namanPuri/Physics-with-arduino/curve tracer output/26_06_2022/4007-diode-curve-v1.png

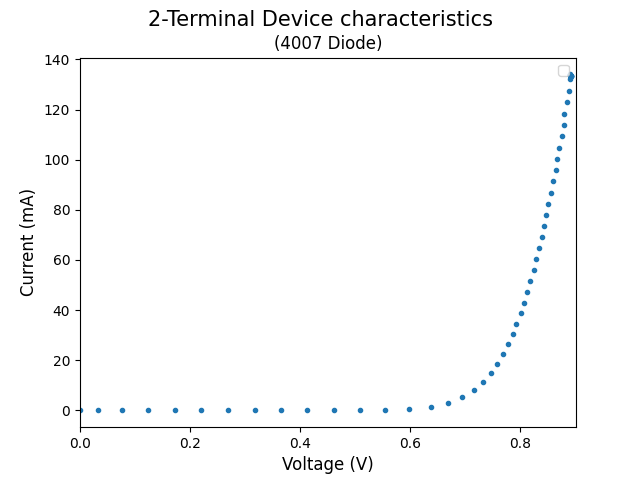
curve tracer output/26_06_2022/4007-diode-curve-v1.png
