namanPuri/Physics-with-arduino/curve tracer output/5819-v1.PNG

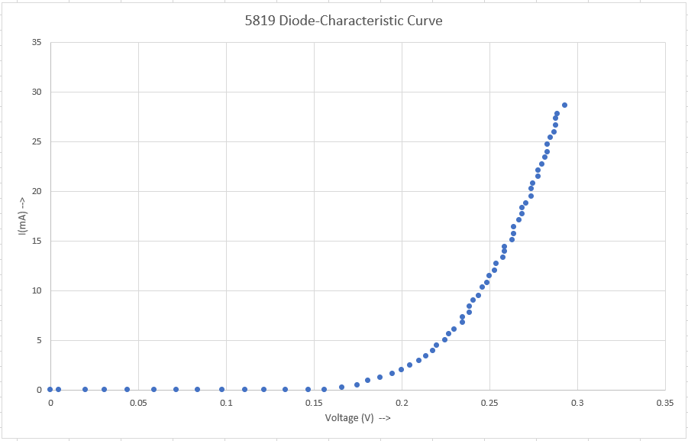
curve tracer output/5819-v1.PNG
