namanPuri/Physics-with-arduino/curve tracer output/5819-v2.PNG

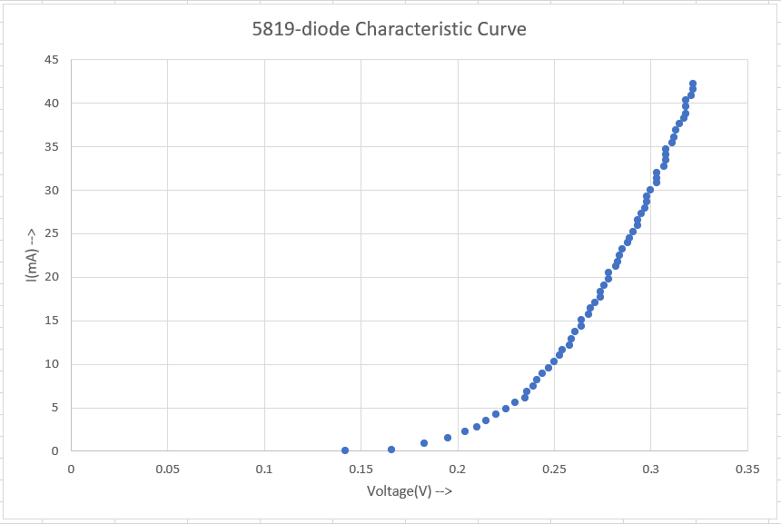
curve tracer output/5819-v2.PNG
