namanPuri/Physics-with-arduino/curve tracer output/blue-led-v1.PNG

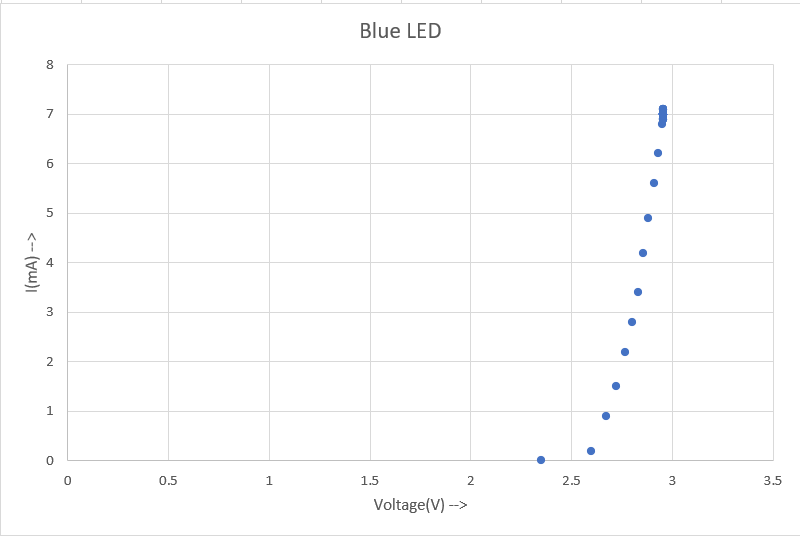
curve tracer output/blue-led-v1.PNG
