namanPuri/Physics-with-arduino/curve tracer output/blue-led-v2-OP07.PNG

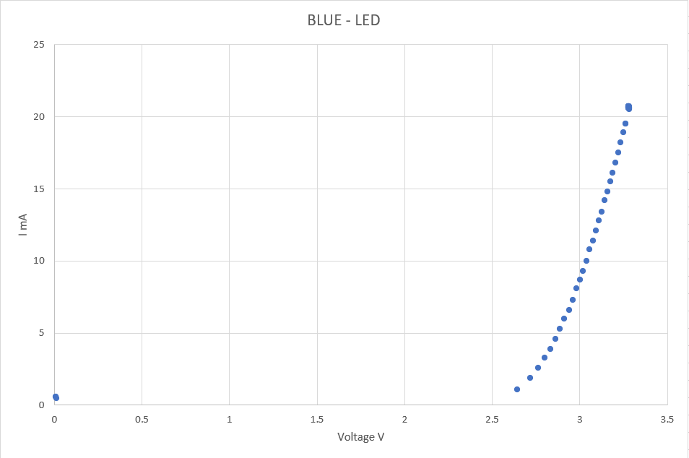
curve tracer output/blue-led-v2-OP07.PNG
