namanPuri/Physics-with-arduino/newtons law of cooling/92-42.PNG

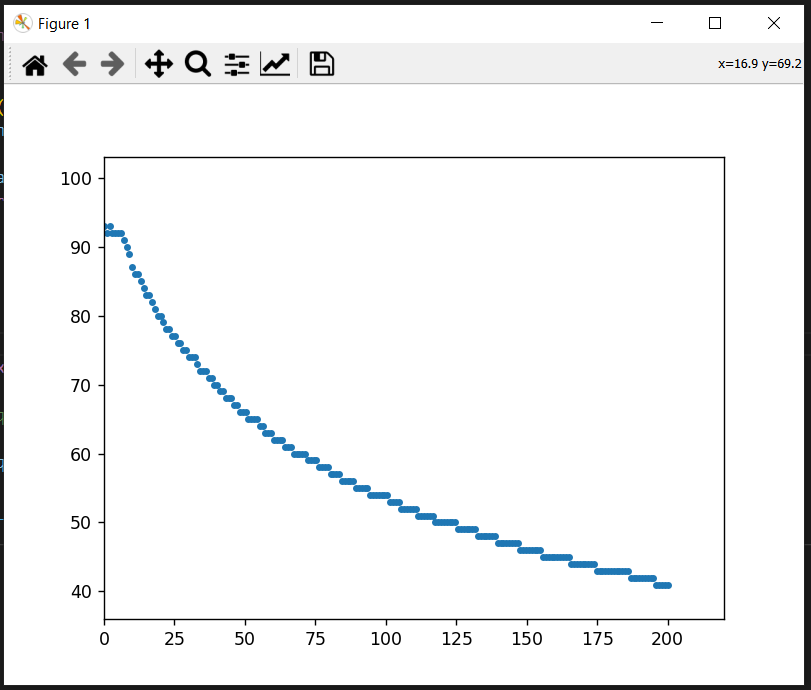
newtons law of cooling/92-42.PNG
