namanPuri/Physics-with-arduino/output/rc-charging-discharging.png

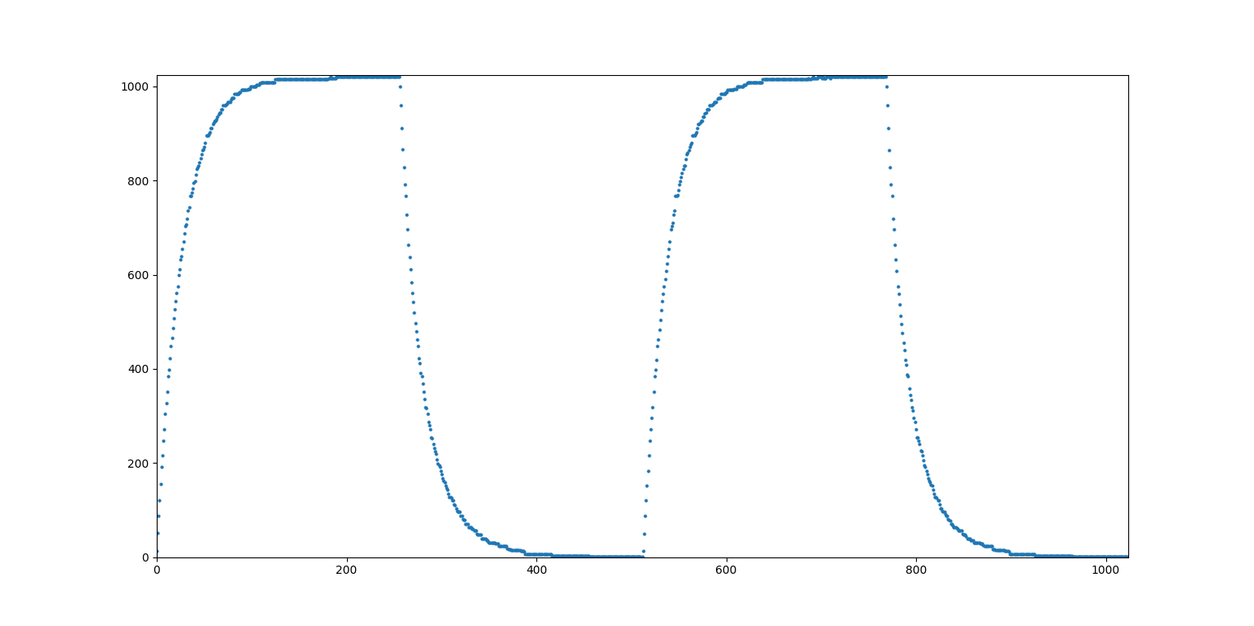
output/rc-charging-discharging.png
