namanPuri/Physics-with-arduino/output/rlc-critically damped.png

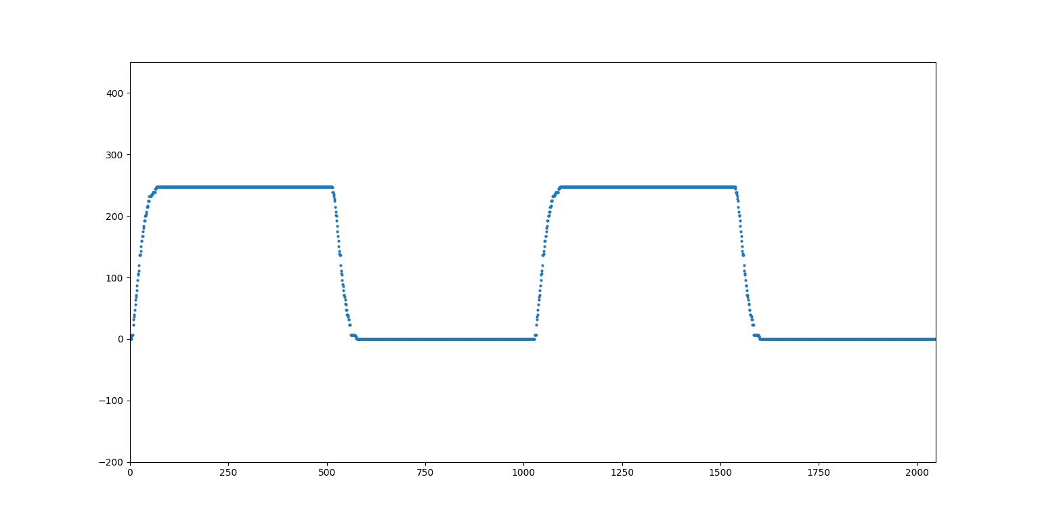
output/rlc-critically damped.png
