namanPuri/Physics-with-arduino/output/rlc-overdamped.png

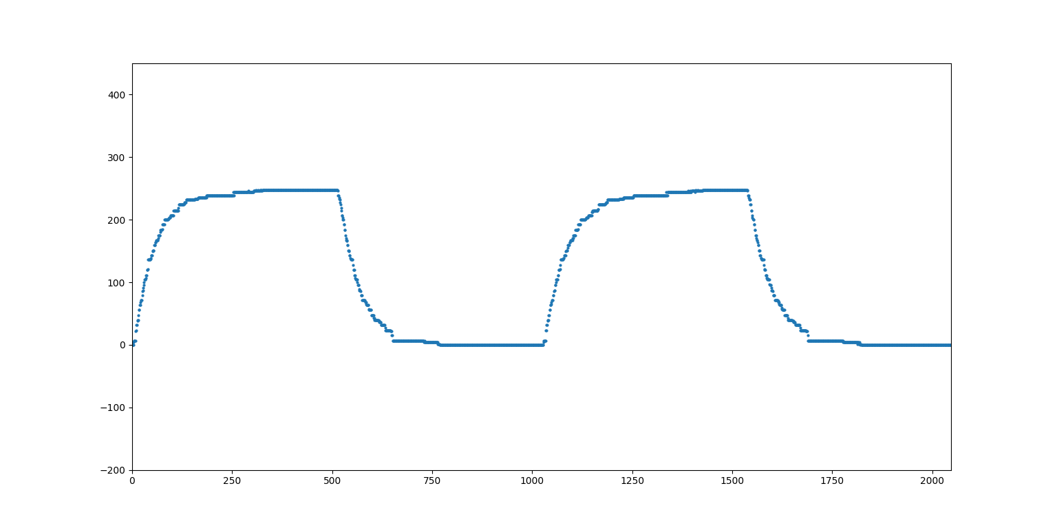
output/rlc-overdamped.png
