namanPuri/Physics-with-arduino/output/rlc-ringing.png

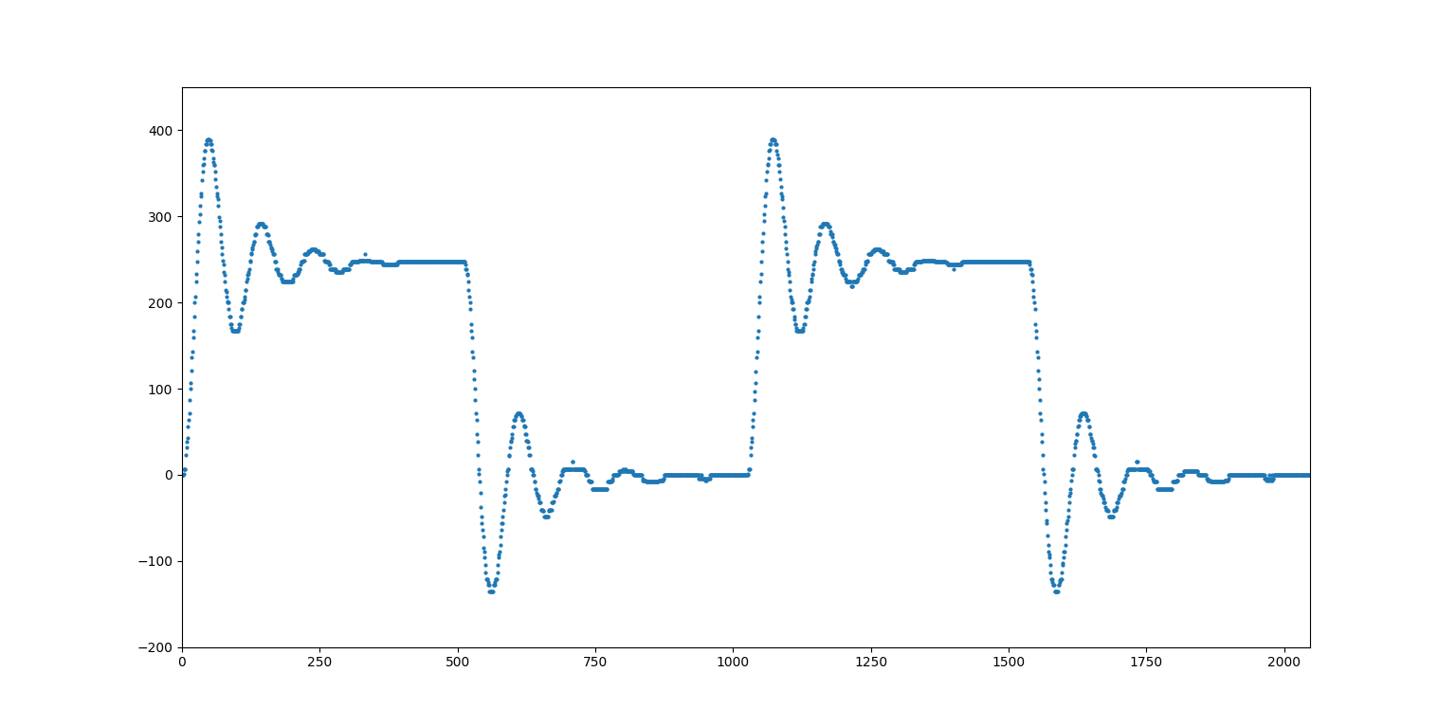
output/rlc-ringing.png
