namanPuri/Physics-with-arduino/ardunio-physics-board-v3.dxf

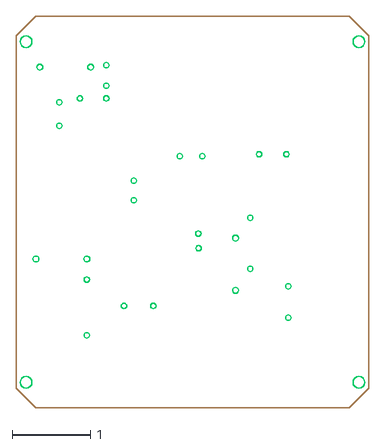
[picture p13: CAD file, 2022-06-27]
ardunio-physics-board-v3.dxf
4.50 x 5.00
