namanPuri/Physics-with-arduino/radiused-0.15.dxf

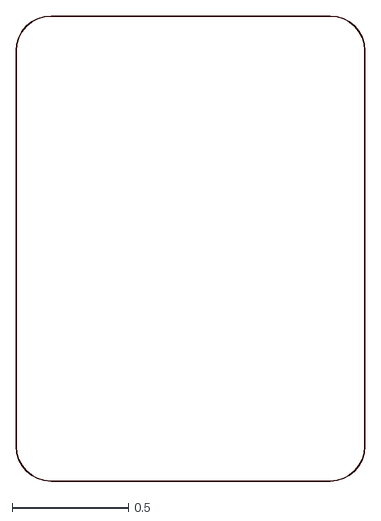
[picture p14: CAD file, 2022-06-27]
radiused-0.15.dxf
1.50 x 2.00
