namanPuri/Physics-with-arduino/Schematic_arduino_physics_V1.pdf

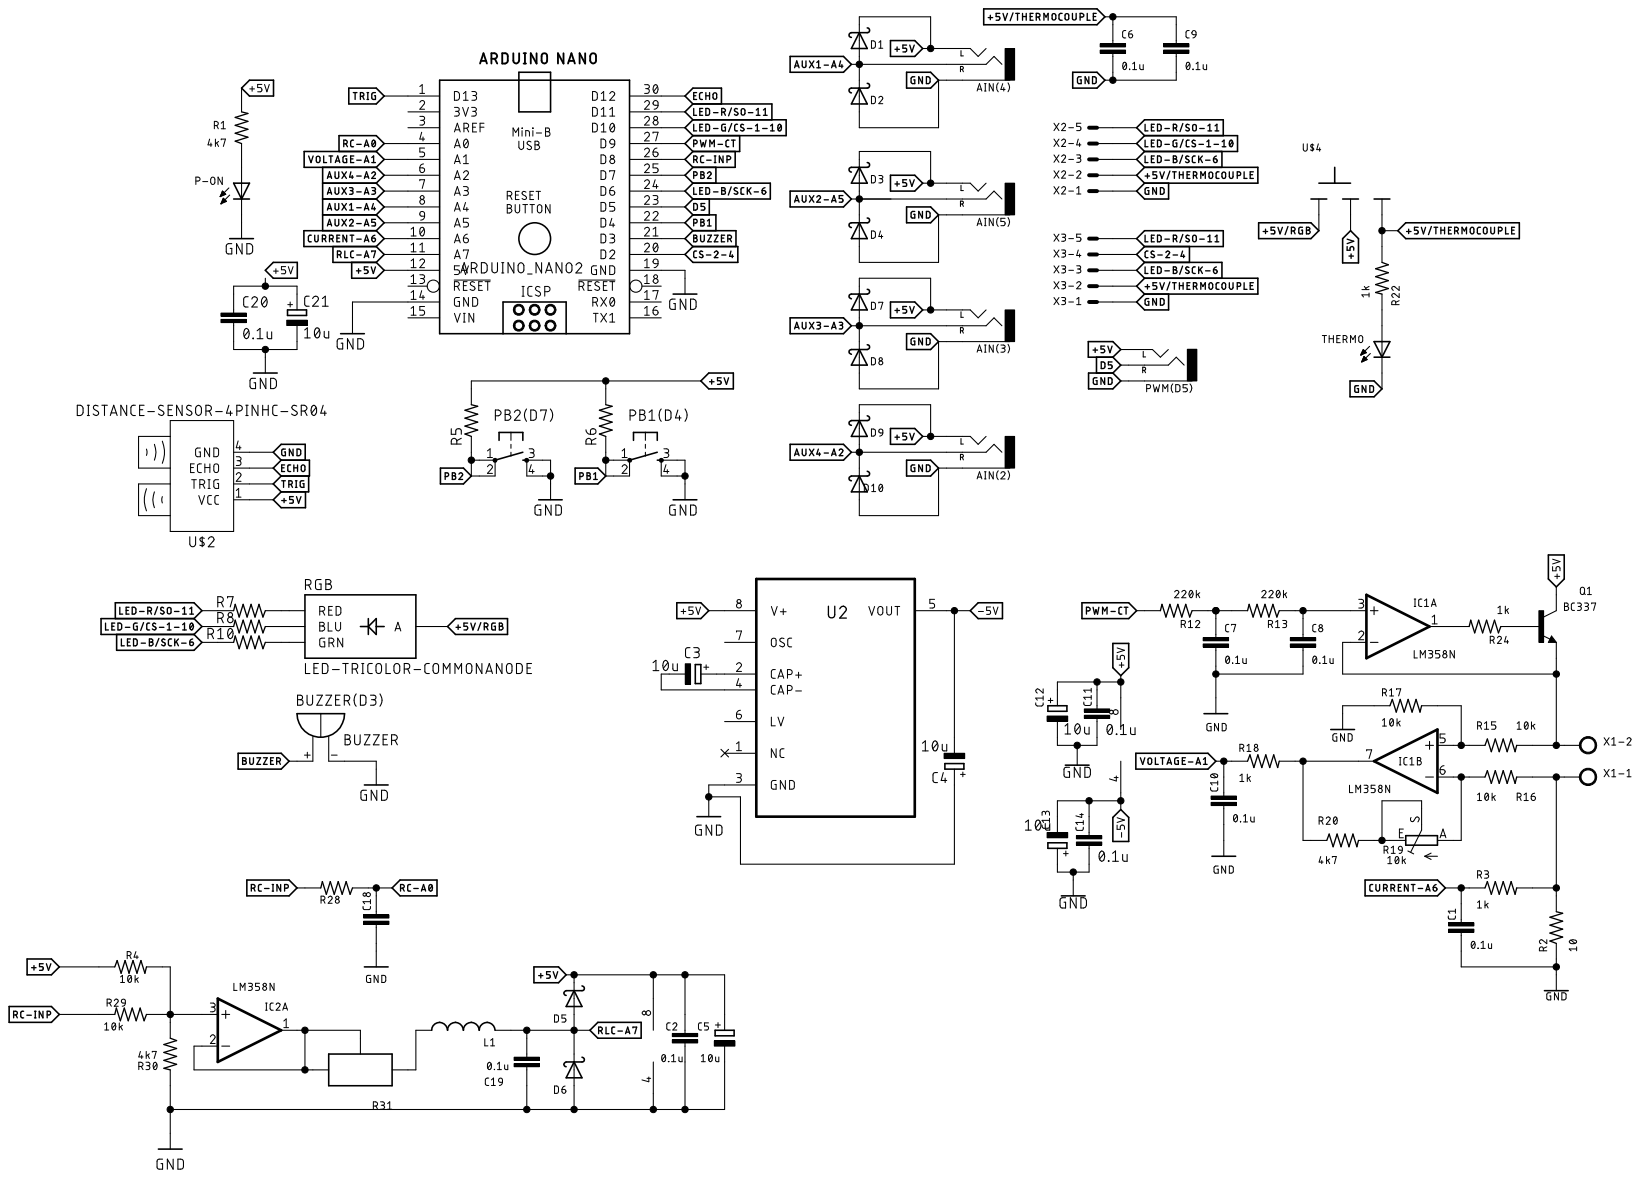
[picture p15: page 1]
