namanPuri/Physics-with-arduino/supplementary boards/mic/mic_v4.brd

## EAGLE design supplementary boards/mic/mic_v4.brd (2022-06-27)

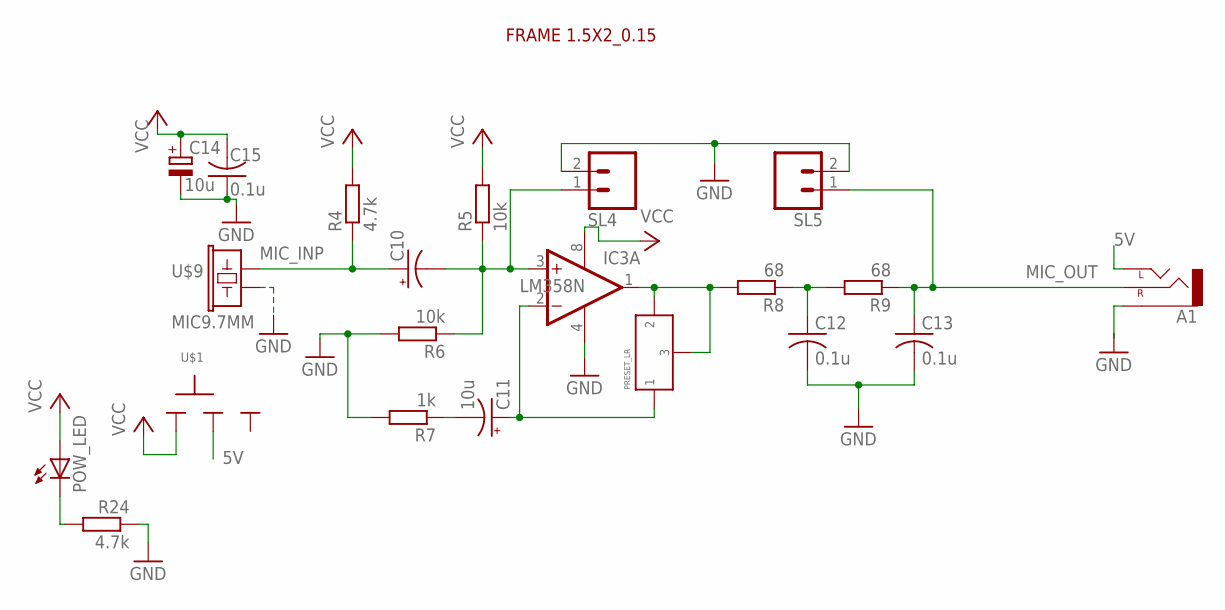
[picture p16: schematic mic_v4.sch]

Parts:
A1: AUX-CONNECTOR_CEDT_JANUARY_2015_V5_AUDIO-JACKPTH; AUX-CONNECTOR_CEDT_JANUARY_2015_V5_AUDIO-JACK
C10: CPOL-USE2.5-5; E2,5-5
C11, C14: 10u; E2,5-5
C12, C13, C15: 0.1u; C025-024X044
IC3: LM358N; DIL08
POW_LED: LED3MM
R4, R24: 4.7k; 0204/7
R5, R6: 10k; 0204/7
R7: 1k; 0204/7
R8, R9: 68; 0204/7
SL4, SL5: M02; 02P
U$1: SLIDESWITCH-BIG; BIGSWITCH
U$2: FRAME_1.5X2_RAD_0.15
U$6: PRESET_LR
U$9: MIC9.7MM; MIC-9.7MM

Connections:
5V: A1.TIP (LEFT), U$1.2
GND: A1.SLEEVE, C12.2, C13.2, C14.-, C15.1, IC3.4 (V-), R6.2, R7.2, R24.1, SL4.2, SL5.2, U$9.2
MIC_INP: C10.+, R4.1, U$9.1
MIC_OUT: A1.RING (RIGHT), C13.1, R9.1, SL5.1
unnamed: IC3.1 (OUT), R8.2, U$6.P$2 (2), U$6.P$3 (3)
unnamed: C12.1, R8.1, R9.2
unnamed: C11.-, R7.1
unnamed: POW_LED.K (C), R24.2
unnamed: C10.-, IC3.3 (+IN), R5.1, R6.1, SL4.1
unnamed: C11.+, IC3.2 (-IN), U$6.P$1 (1)
VCC: C14.+, C15.2, IC3.8 (V+), POW_LED.A, R4.2, R5.2, U$1.1

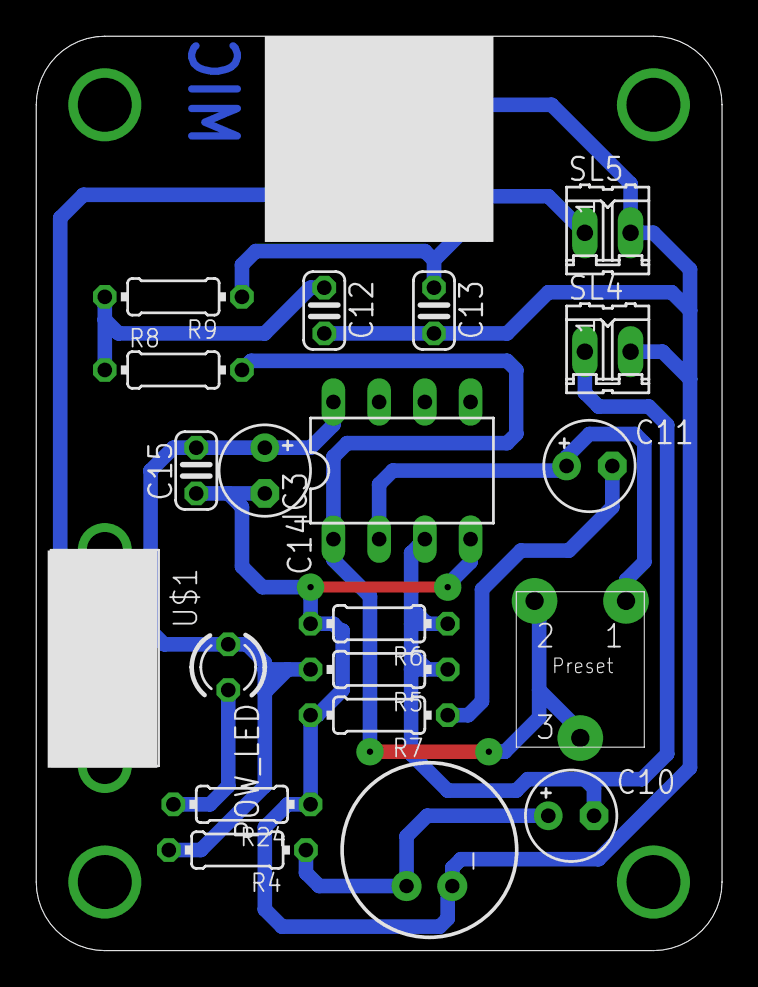
[picture p17: board mic_v4.brd from above]

Board: 2 copper layers, 38.1 x 50.8 mm, 22 parts (0 on the bottom side), 11 nets.
