namanPuri/Physics-with-arduino/supplementary boards/sos/SOS-v2.brd

## EAGLE design supplementary boards/sos/SOS-v2.brd (2022-06-27)

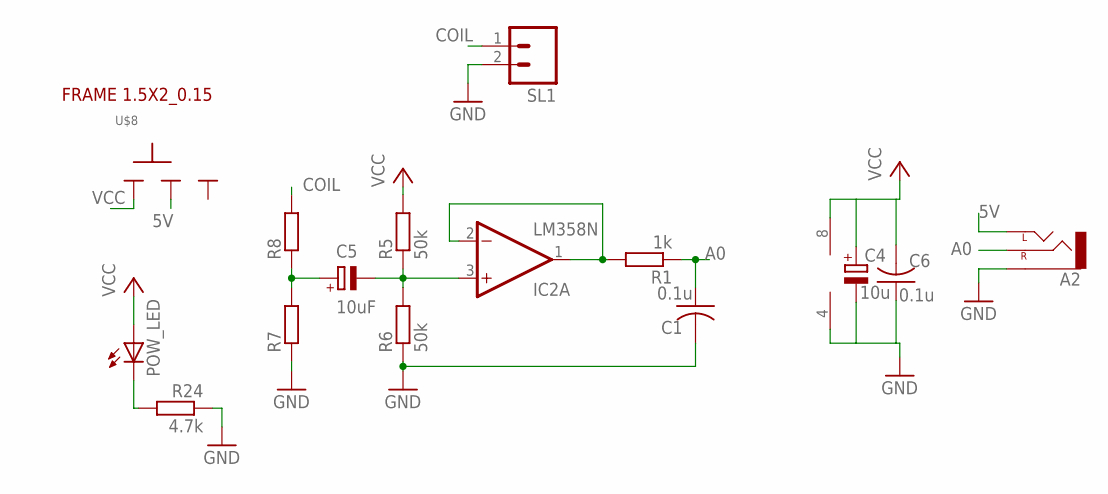
[picture p18: schematic SOS-v2.sch]

Parts:
A2: AUX-CONNECTOR_CEDT_JANUARY_2015_V5_AUDIO-JACKPTH; AUX-CONNECTOR_CEDT_JANUARY_2015_V5_AUDIO-JACK
C1, C6: 0.1u; C025-024X044
C4: 10u; E2,5-5
C5: 10uF; E2,5-6
IC2: LM358N; DIL08
POW_LED: LED3MM
R1: 1k; 0204/7
R5, R6: 50k; 0204/7
R7, R8: R-EU_0204/7; 0204/7
R24: 4.7k; 0204/7
SL1: M02; 02P
U$1: FRAME_1.5X2_RAD_0.15
U$8: SLIDESWITCH-BIG; BIGSWITCH

Connections:
5V: A2.TIP (LEFT), U$8.2
A0: A2.RING (RIGHT), C1.1, R1.1
CLAMP_SIGNAL: C5.-, IC2.3 (+IN), R5.1, R6.2
COIL: R8.2, SL1.1
GND: A2.SLEEVE, C1.2, C4.-, C6.1, IC2.4 (V-), R6.1, R7.1, R24.1, SL1.2
unnamed: C5.+, R7.2, R8.1
unnamed: IC2.1 (OUT), IC2.2 (-IN), R1.2
unnamed: POW_LED.K (C), R24.2
VCC: C4.+, C6.2, IC2.8 (V+), POW_LED.A, R5.2, U$8.1

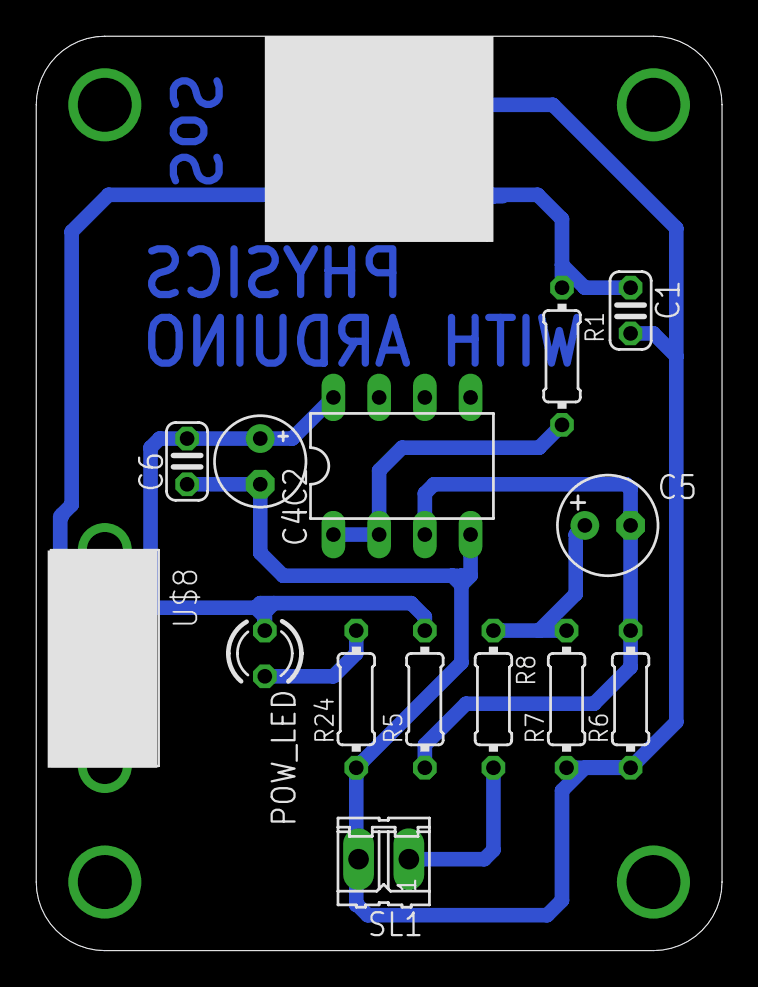
[picture p19: board SOS-v2.brd from above]

Board: 2 copper layers, 38.1 x 50.8 mm, 16 parts (0 on the bottom side), 9 nets.
