namanPuri/Physics-with-arduino/ardunio-physics-board-v2.brd

## EAGLE design ardunio-physics-board-v2.brd (2022-06-27, an earlier design)

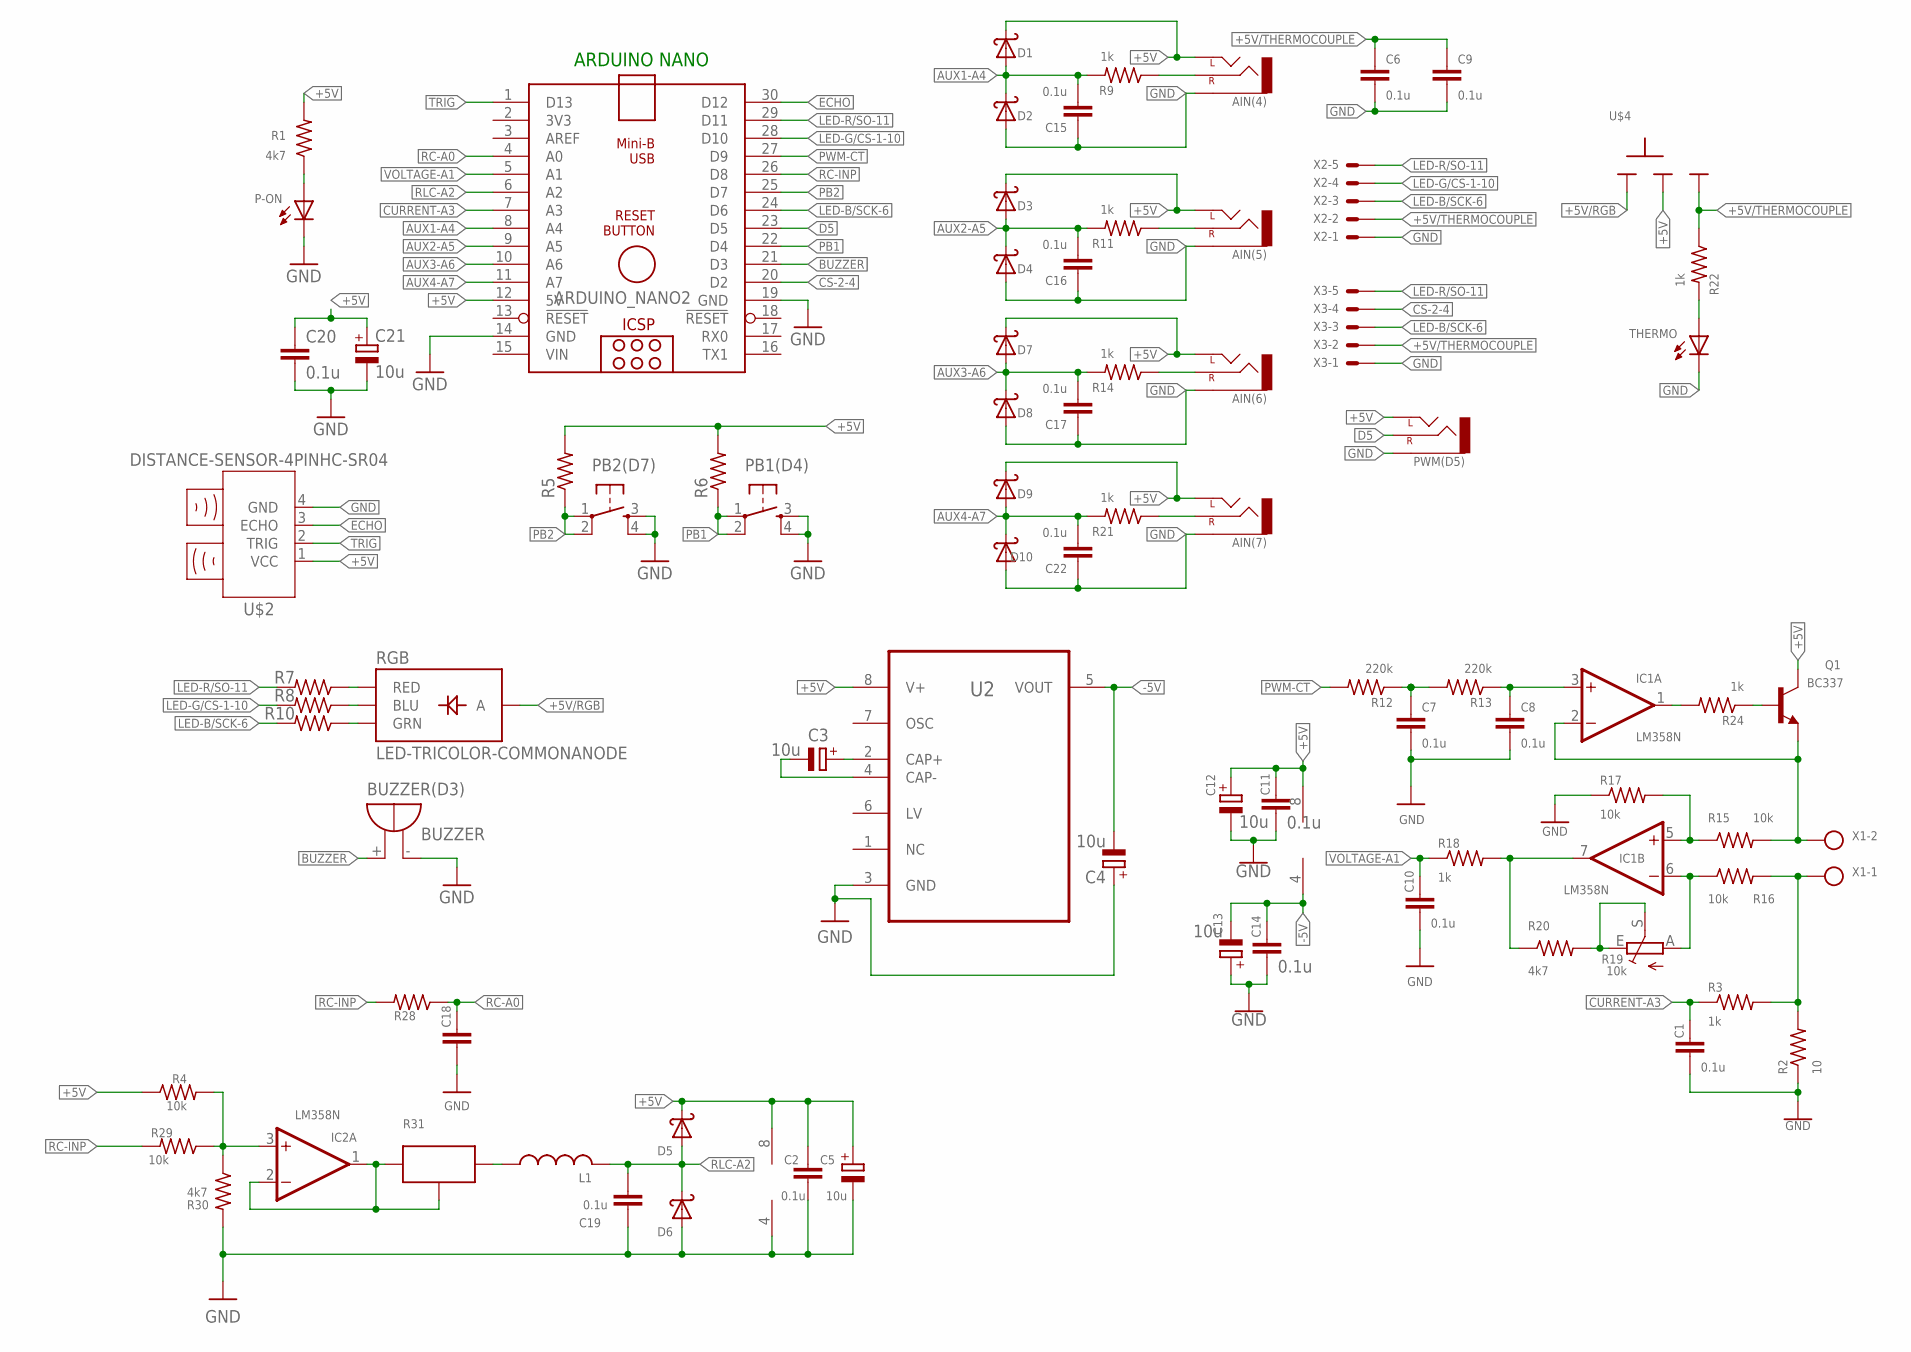
[picture p20: schematic ardunio-physics-board-v2.sch]

Parts:
AIN(4), AIN(5), AIN(6), AIN(7): AUX-CONNECTOR_CEDT_JANUARY_2015_V5_AUDIO-JACKPTH; AUX-CONNECTOR_CEDT_JANUARY_2015_V5_AUDIO-JACK
ARDUINO_NANO2: ARDUINONANOV30_ARDUINO_NANO
BUZZER(D3): BUZZER; F/TMB
C1, C2, C7, C8, C10, C11, C14, C19: 0.1u; C025-025X050
C3, C4, C5, C12, C13: 10u; TT2D5
C6, C9, C15, C16, C17, C20, C22: 0.1u; C025-024X044
C18: C-EU025-025X050; C025-025X050
C21: 10u; E2,5-5
D1, D2, D3, D4, D5, D6, D7, D8, D9, D10: 1N5819; DO41-10
IC1, IC2: LM358N; DIL08
L1: L-US6000-XXX-RC; 6000-XXXX-RC
P-ON: LED3MM
PB1(D4), PB2(D7): OMRON_SWITCH_40-XX; B3F-40XX
PWM(D5): AUX-CONNECTOR_CEDT_JANUARY_2015_V5_AUDIO-JACKPTH; AUX-CONNECTOR_CEDT_JANUARY_2015_V5_AUDIO-JACK
Q1: BC337; TO92
R1, R20: 4k7; 0204/7
R2: 10; 0207/10
R3, R9, R11, R14, R18, R21, R22, R24: 1k; 0204/7
R4: 10k; 0207/10
R5, R6: R-US_0204/7; 0204/7
R7, R8, R10, R28: R-US_0207/10; 0207/10
R12: 220k; 0207/10
R13: 220k; 0204/7
R15, R16, R17, R29: 10k; 0204/7
R19: 10k; RJ9W
R30: 4k7; 0207/10
R31: POTNORMAL; RJ9W
RGB: LED-TRICOLOR-COMMONANODE; LED-TRICOLOR-THROUGHHOLE
THERMO: LED3MM
U2: ICL7660CPAZ_ICL7660CPAZ; ICL7660CPAZ_DIP254P762X533-8
U$2: DISTANCE-SENSOR-4PINHC-SR04; HC-SR04
U$4: SLIDESWITCH-BIG; BIGSWITCH
X1: AK500/2-H
X2, X3: JST-XH-05-PIN-LONG-PAD; JST-XH-05-PACKAGE-LONG-PAD

Connections:
+5V: AIN(4).TIP (LEFT), AIN(5).TIP (LEFT), AIN(6).TIP (LEFT), AIN(7).TIP (LEFT), ARDUINO_NANO2.12 (5V), C2.1, C5.+, C11.1, C12.+, C20.1, C21.+, D1.C, D3.C, D5.C, D7.C, D9.C, IC1.8 (V+), IC2.8 (V+), PWM(D5).TIP (LEFT), Q1.3 (C), R1.2, R4.1, R5.2, R6.2, U2.8 (V+), U$2.1 (VCC), U$4.2
+5V/RGB: RGB.ANODE (A), U$4.1
+5V/THERMOCOUPLE: C6.1, C9.1, R22.1, U$4.3, X2.2, X3.2
-5V: C4.-, C13.-, C14.1, IC1.4 (V-), U2.5 (VOUT)
AUX1-A4: ARDUINO_NANO2.8 (A4), C15.2, D1.A, D2.C, R9.2
AUX2-A5: ARDUINO_NANO2.9 (A5), C16.2, D3.A, D4.C, R11.2
AUX3-A6: ARDUINO_NANO2.10 (A6), C17.2, D7.A, D8.C, R14.2
AUX4-A7: ARDUINO_NANO2.11 (A7), C22.2, D9.A, D10.C, R21.2
BUZZER: ARDUINO_NANO2.21 (D3), BUZZER(D3).+
CS-2-4: ARDUINO_NANO2.20 (D2), X3.4
CURRENT-A3: ARDUINO_NANO2.7 (A3), C1.1, R3.1
D5: ARDUINO_NANO2.23 (D5), PWM(D5).RING (RIGHT)
ECHO: ARDUINO_NANO2.30 (D12), U$2.3 (ECHO)
GND: AIN(4).SLEEVE, AIN(5).SLEEVE, AIN(6).SLEEVE, AIN(7).SLEEVE, ARDUINO_NANO2.14 (GND), ARDUINO_NANO2.19 (GND), BUZZER(D3).-, C1.2, C2.2, C4.+, C5.-, C6.2, C7.2, C8.2, C9.2, C10.2, C11.2, C12.-, C13.+, C14.2, C15.1, C16.1, C17.1, C18.2, C19.2, C20.2, C21.-, C22.1, D2.A, D4.A, D6.A, D8.A, D10.A, IC2.4 (V-), P-ON.K (C), PB1(D4).3 (S), PB1(D4).4 (S1), PB2(D7).3 (S), PB2(D7).4 (S1), PWM(D5).SLEEVE, R2.1, R17.1, R30.2, THERMO.K (C), U2.3 (GND), U$2.4 (GND), X2.1, X3.1
LED-B/SCK-6: ARDUINO_NANO2.24 (D6), R10.2, X2.3, X3.3
LED-G/CS-1-10: ARDUINO_NANO2.28 (D10), R8.2, X2.4
LED-R/SO-11: ARDUINO_NANO2.29 (D11), R7.2, X2.5, X3.5
unnamed: IC1.2 (-IN), Q1.1 (E), R15.2, X1.2
unnamed: R7.1, RGB.RED
unnamed: R8.1, RGB.BLU
unnamed: R10.1, RGB.GRN
unnamed: IC1.1 (OUT), R24.2
unnamed: C8.1, IC1.3 (+IN), R13.1
unnamed: IC2.3 (+IN), R4.2, R29.1, R30.1
unnamed: C3.+, U2.2 (CAP+)
unnamed: C3.-, U2.4 (CAP-)
unnamed: C7.1, R12.1, R13.2
unnamed: R2.2, R3.2, R16.2, X1.1
unnamed: P-ON.A, R1.1
unnamed: Q1.2 (B), R24.1
unnamed: IC2.1 (OUT), IC2.2 (-IN), R31.E, R31.S
unnamed: AIN(4).RING (RIGHT), R9.1
unnamed: IC1.5 (+IN), R15.1, R17.2
unnamed: IC1.6 (-IN), R16.1, R19.A
unnamed: R19.E, R19.S, R20.2
unnamed: IC1.7 (OUT), R18.2, R20.1
unnamed: AIN(5).RING (RIGHT), R11.1
unnamed: L1.1, R31.A
unnamed: R22.2, THERMO.A
unnamed: AIN(6).RING (RIGHT), R14.1
unnamed: AIN(7).RING (RIGHT), R21.1
PB1: ARDUINO_NANO2.22 (D4), PB1(D4).1, PB1(D4).2 (P1), R6.1
PB2: ARDUINO_NANO2.25 (D7), PB2(D7).1, PB2(D7).2 (P1), R5.1
PWM-CT: ARDUINO_NANO2.27 (D9), R12.2
RC-A0: ARDUINO_NANO2.4 (A0), C18.1, R28.1
RC-INP: ARDUINO_NANO2.26 (D8), R28.2, R29.2
RLC-A2: ARDUINO_NANO2.6 (A2), C19.1, D5.A, D6.C, L1.2
TRIG: ARDUINO_NANO2.1 (D13), U$2.2 (TRIG)
VIN: ARDUINO_NANO2.15 (VIN)
VOLTAGE-A1: ARDUINO_NANO2.5 (A1), C10.1, R18.1

Notes on the sheet:
ARDUINO NANO

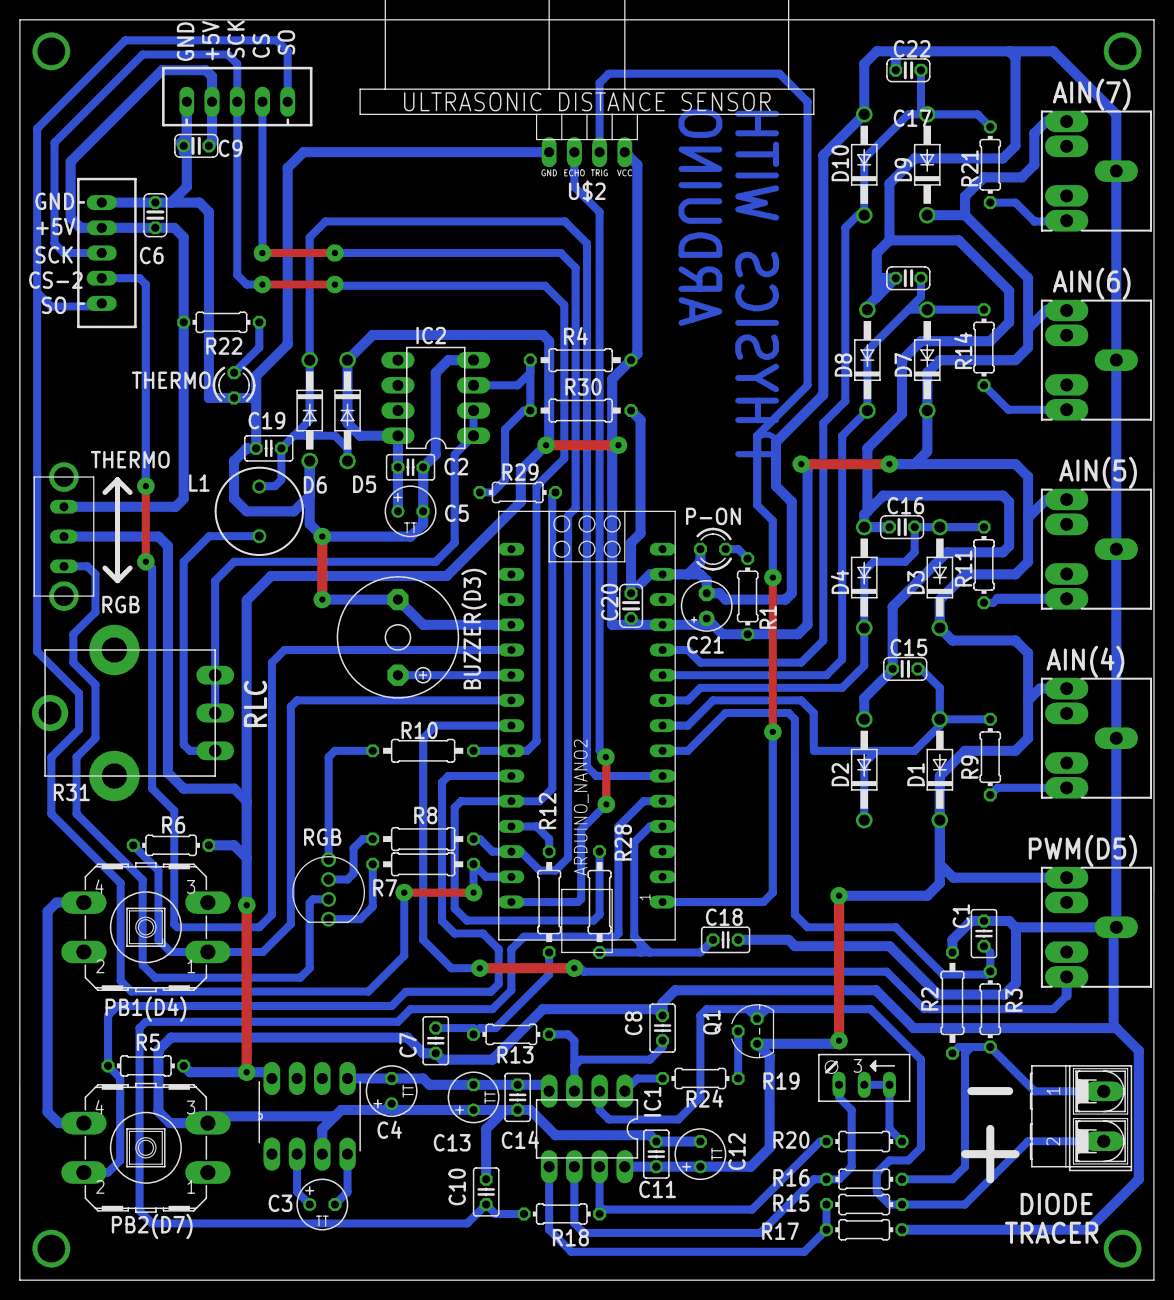
[picture p21: board ardunio-physics-board-v2.brd from above]

Board: 2 copper layers, 114.3 x 127.0 mm, 81 parts (0 on the bottom side), 49 nets.
