namanPuri/Physics-with-arduino/supplementary boards/IR/IR.brd

## EAGLE design supplementary boards/IR/IR.brd (2022-06-27)

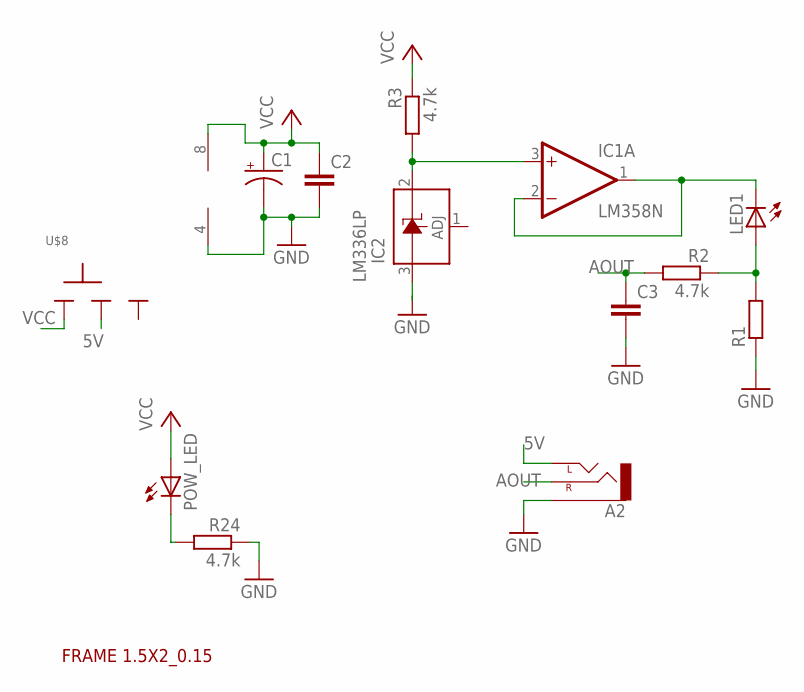
[picture p22: schematic IR.sch]

Parts:
A2: AUX-CONNECTOR_CEDT_JANUARY_2015_V5_AUDIO-JACKPTH; AUX-CONNECTOR_CEDT_JANUARY_2015_V5_AUDIO-JACK
C1: CAP_POL; E2,5-5-10U
C2, C3: C-EU025-024X044; C025-024X044
IC1: LM358N; DIL08
IC2: LM336LP; TO92
LED1: LED5MM
POW_LED: LED3MM
R1: R-EU_0204/7; 0204/7
R2, R3, R24: 4.7k; 0204/7
U$1: FRAME_1.5X2_RAD_0.15
U$8: SLIDESWITCH-BIG; BIGSWITCH

Connections:
5V: A2.TIP (LEFT), U$8.2
AOUT: A2.RING (RIGHT), C3.1, R2.2
GND: A2.SLEEVE, C1.-, C2.2, C3.2, IC1.4 (V-), IC2.3 (A), R1.1, R24.1
unnamed: IC1.3 (+IN), IC2.2 (C), R3.2
unnamed: LED1.A, R1.2, R2.1
unnamed: IC1.1 (OUT), IC1.2 (-IN), LED1.K (C)
unnamed: POW_LED.K (C), R24.2
VCC: C1.+, C2.1, IC1.8 (V+), POW_LED.A, R3.1, U$8.1

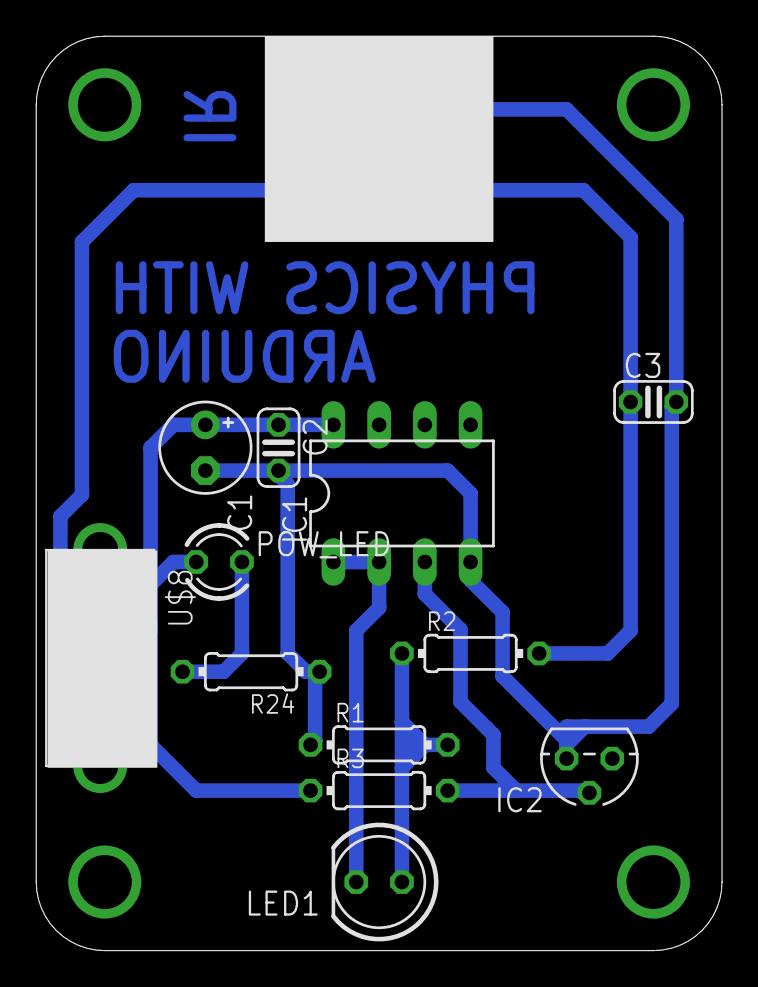
[picture p23: board IR.brd from above]

Board: 2 copper layers, 38.1 x 50.8 mm, 14 parts (0 on the bottom side), 8 nets.
