namanPuri/Physics-with-arduino/ph_tl082_v3/pH_tl082_v3.brd

## EAGLE design ph_tl082_v3/pH_tl082_v3.brd (2022-06-27)

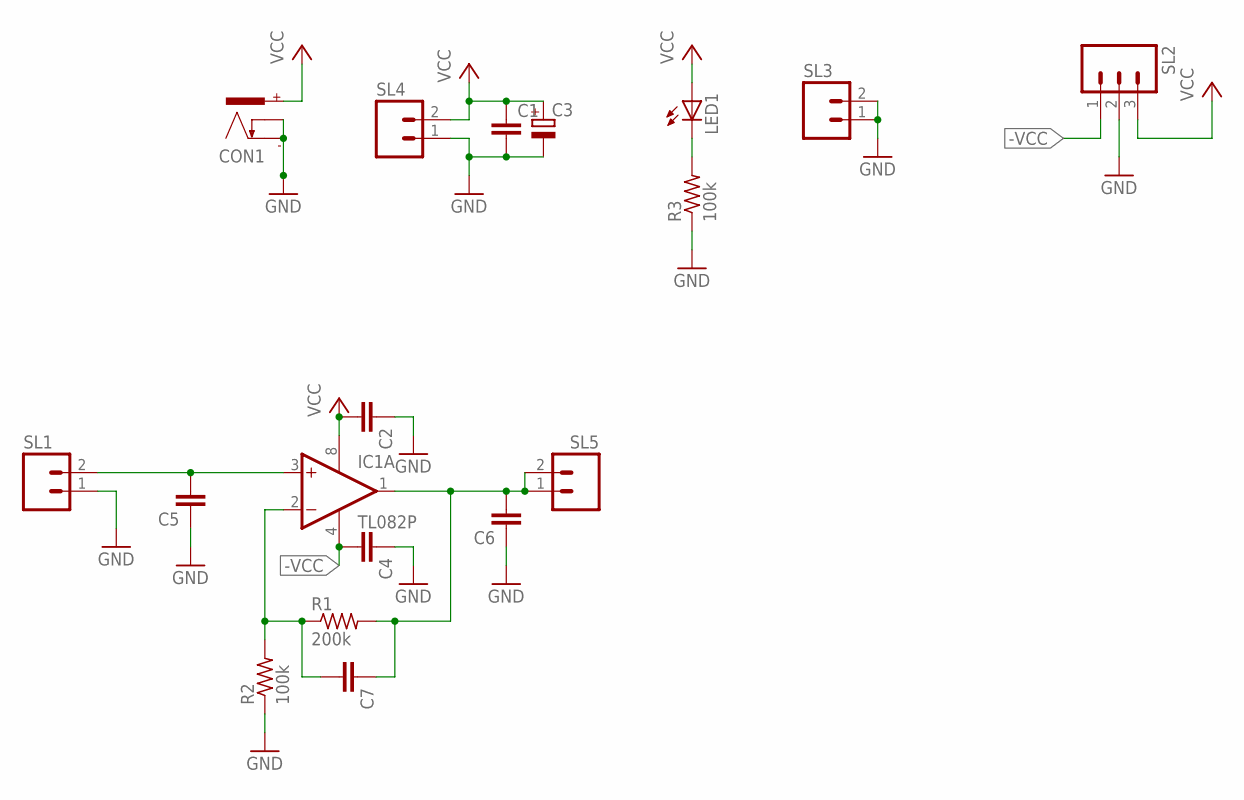
[picture p24: schematic pH_tl082_v3.sch]

Parts:
C1, C2, C4, C5, C6, C7: C2.5/2; C2.5-2
C3: CPOL-EUE2,5-6E; E2,5-6E
CON1: POWER_CON; NEB21R
IC1: TL082P; DIL08
LED1: LED3MM
R1: 200k; 0207/7
R2, R3: 100k; 0207/7
SL1, SL3, SL4, SL5: M02; 02P
SL2: M03; 03P

Connections:
-VCC: C4.2, IC1.4 (V-), SL2.1
GND: C1.2, C2.1, C3.-, C4.1, C5.1, C6.1, CON1.-, CON1.C, R2.1, R3.1, SL1.1, SL2.2, SL3.1, SL3.2, SL4.1
unnamed: C5.2, IC1.3 (+IN), SL1.2
unnamed: C7.2, IC1.2 (-IN), R1.1, R2.2
unnamed: C6.2, C7.1, IC1.1 (OUT), R1.2, SL5.1, SL5.2
unnamed: LED1.K (C), R3.2
VCC: C1.1, C2.2, C3.+, CON1.+, IC1.8 (V+), LED1.A, SL2.3, SL4.2

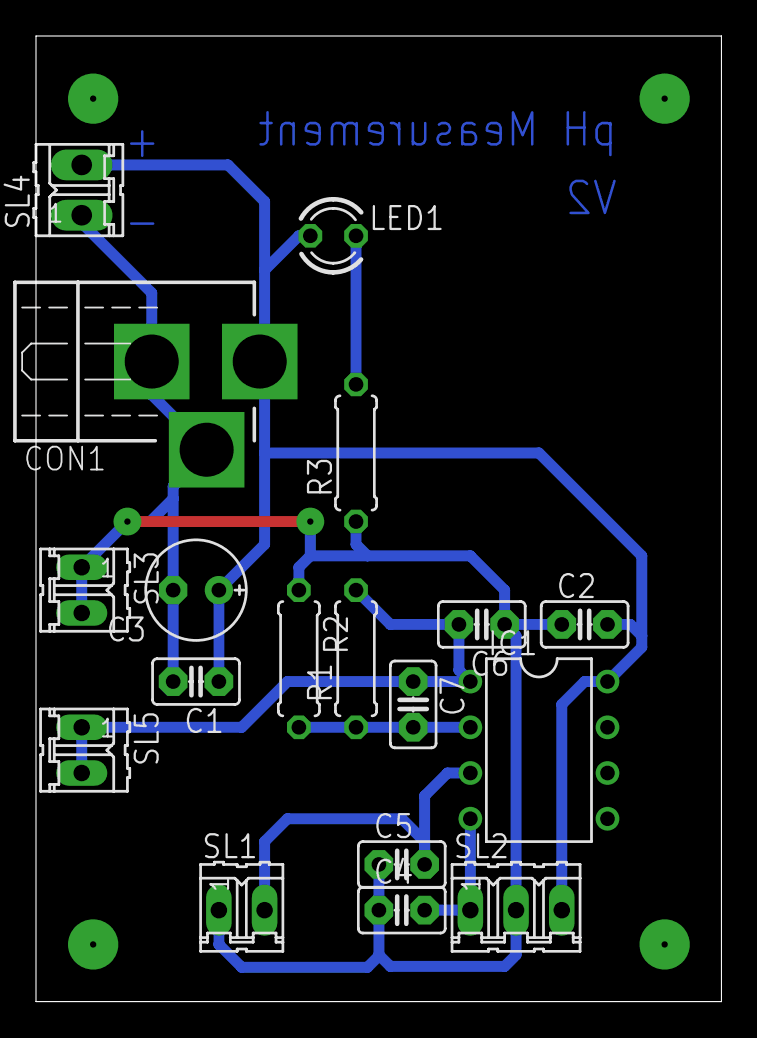
[picture p25: board pH_tl082_v3.brd from above]

Board: 2 copper layers, 38.1 x 53.6 mm, 18 parts (0 on the bottom side), 7 nets.
