namanPuri/Physics-with-arduino/ardunio-physics-board-v1.brd

## EAGLE design ardunio-physics-board-v1.brd (2022-06-27, an earlier design)

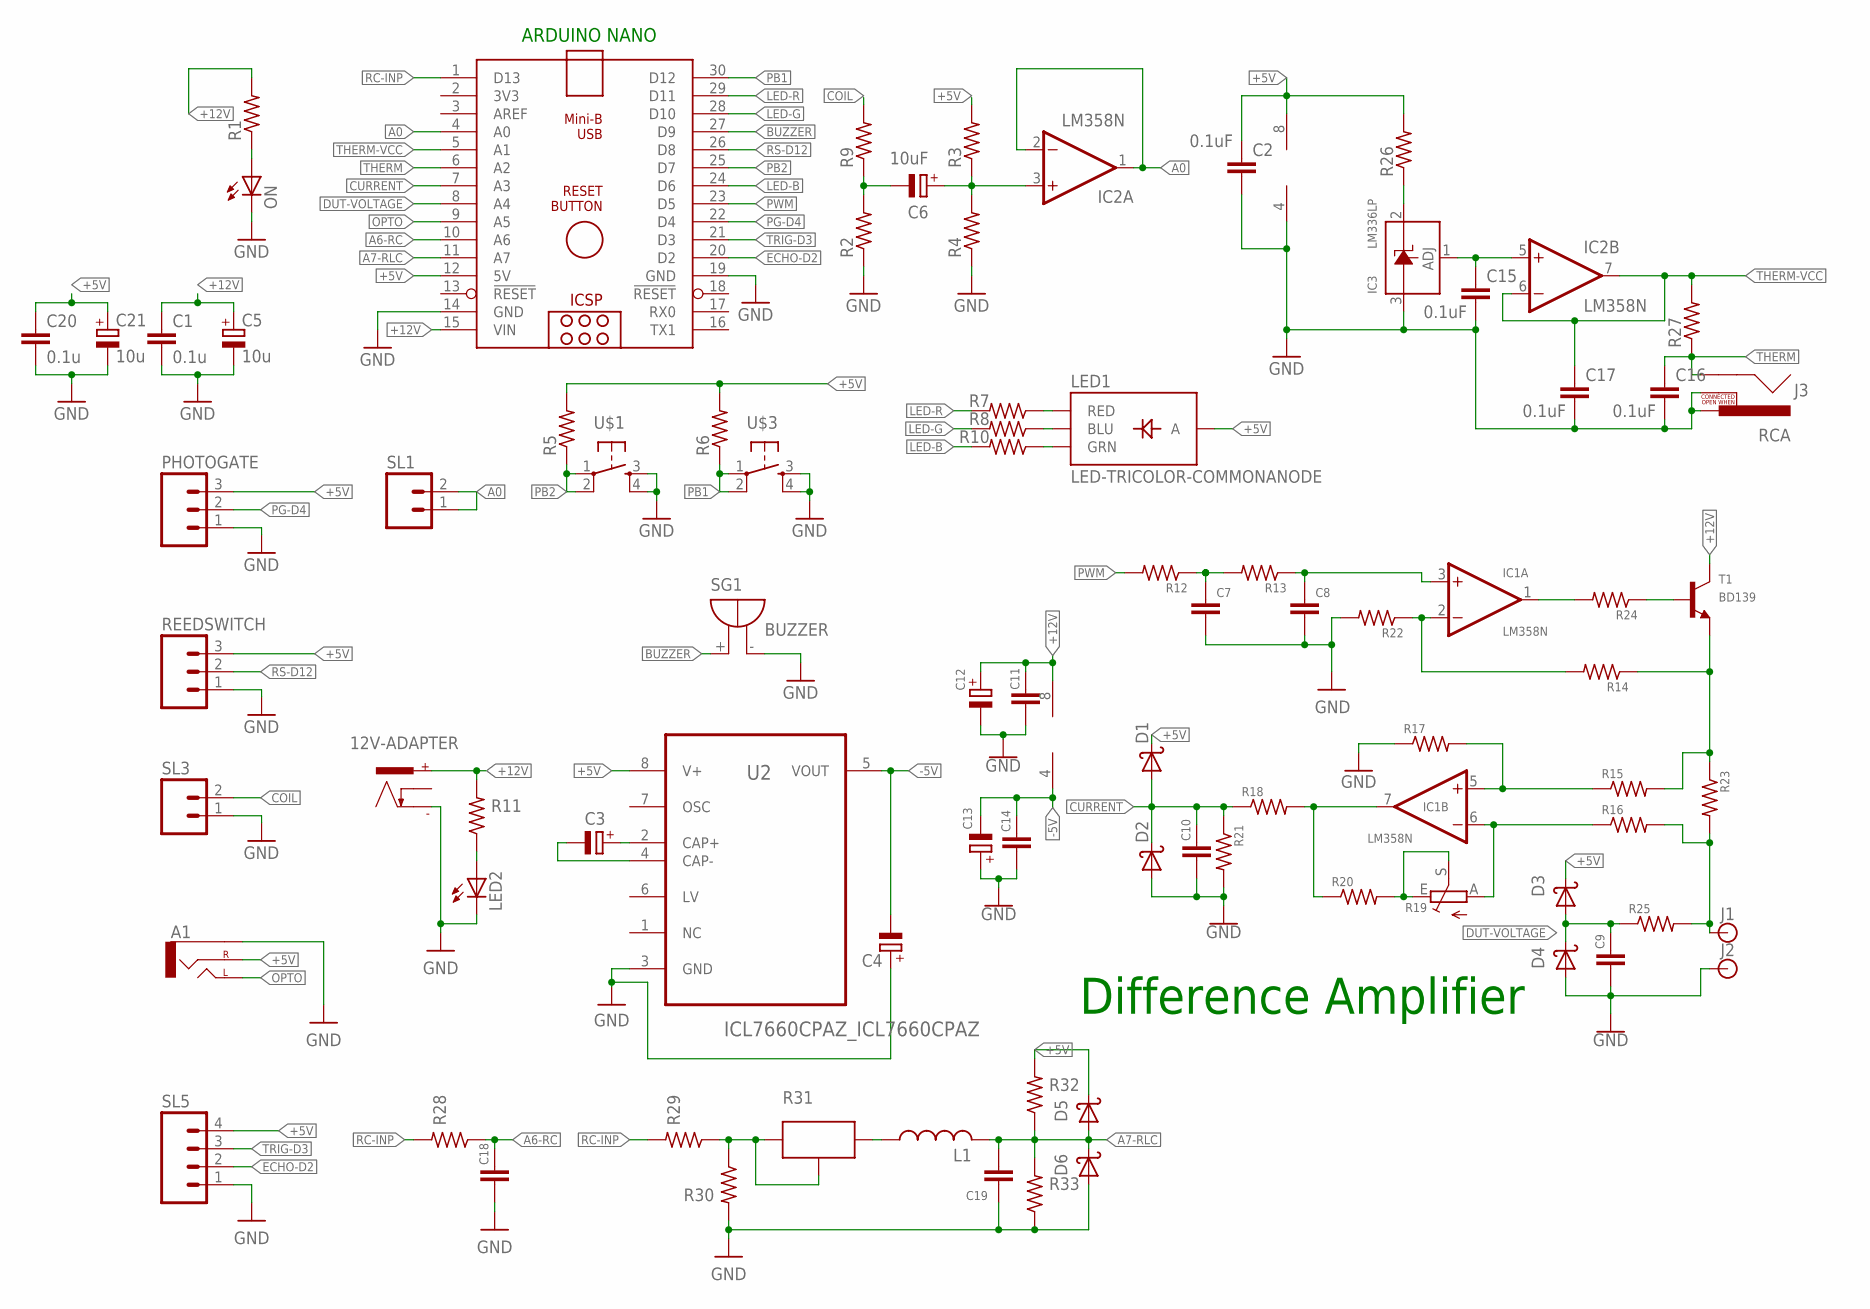
[picture p26: schematic ardunio-physics-board-v1.sch]

Parts:
12V-ADAPTER: POWER_CON; NEB21R
A1: CEDT_JANUARY_2015_V5_AUDIO-JACKPTH; CEDT_JANUARY_2015_V5_AUDIO-JACK
ARDUINO_NANO1: ARDUINO_NANO
C1, C20: 0.1u; C025-024X044
C2, C15, C16, C17: 0.1uF; C025-025X050
C3, C4, C12, C13: CPOL-EUTT2D5; TT2D5
C5, C21: 10u; E2,5-5
C6: 10uF; E2,5-6
C7, C8, C9, C10, C11, C14, C18, C19: C-EU025-025X050; C025-025X050
D1, D2, D3, D4, D5, D6: 1N5819; DO41-10
IC1, IC2: LM358N; DIL08
IC3: LM336LP; TO92
J1, J2: BANANA_CONN
J3: RCA
L1: L-US6000-XXX-RC; 6000-XXXX-RC
LED1: LED-TRICOLOR-COMMONANODE; LED-TRICOLOR-THROUGHHOLE
LED2: LED3MM
ON: LED3MM
PHOTOGATE: M03; 03P
R1, R2, R3, R4, R5, R6, R7, R8, R9, R10, R11, R12, R13, R14, R15, R16, R17, R18, R20, R21, R22, R24, R25, R26, R27, R28, R29, R30, R32, R33: R-US_0204/7; 0204/7
R19: TRIM_EU-RJ9W; RJ9W
R23: R-US_0207/10; 0207/10
R31: POTNORMAL; RJ9W
REEDSWITCH: M03; 03P
SG1: BUZZER; F/TMB
SL1, SL3: M02; 02P
SL5: M04; 04P
T1: BD139; TO126
U2: ICL7660CPAZ_ICL7660CPAZ; ICL7660CPAZ_DIP254P762X533-8
U$1, U$3: OMRON_SWITCH_40-XX; B3F-40XX

Connections:
+5V: A1.RING (RIGHT), ARDUINO_NANO1.12 (5V), C2.1, C20.1, C21.+, D1.C, D3.C, D5.C, IC2.8 (V+), LED1.ANODE (A), PHOTOGATE.3, R3.2, R5.2, R6.2, R26.2, R32.2, REEDSWITCH.3, SL5.4, U2.8 (V+)
+12V: 12V-ADAPTER.+, ARDUINO_NANO1.15 (VIN), C1.1, C5.+, C11.1, C12.+, IC1.8 (V+), R1.2, R11.2, T1.2 (C)
-5V: C4.-, C13.-, C14.1, IC1.4 (V-), U2.5 (VOUT)
A0: ARDUINO_NANO1.4 (A0), IC2.1 (OUT), IC2.2 (-IN), SL1.1, SL1.2
A6-RC: ARDUINO_NANO1.10 (A6), C18.1, R28.1
A7-RLC: ARDUINO_NANO1.11 (A7), C19.1, D5.A, D6.C, L1.2, R32.1, R33.2
BUZZER: ARDUINO_NANO1.27 (D9), SG1.+
CLAMP_SIGNAL: C6.+, IC2.3 (+IN), R3.1, R4.2
COIL: R9.2, SL3.2
CURRENT: ARDUINO_NANO1.7 (A3), C10.1, D1.A, D2.C, R18.1, R21.1
DUT-VOLTAGE: ARDUINO_NANO1.8 (A4), C9.1, D3.A, D4.C, R25.1
ECHO-D2: ARDUINO_NANO1.20 (D2), SL5.2
GND: 12V-ADAPTER.-, A1.SLEEVE, ARDUINO_NANO1.14 (GND), ARDUINO_NANO1.19 (GND), C1.2, C2.2, C4.+, C5.-, C7.2, C8.2, C9.2, C10.2, C11.2, C12.-, C13.+, C14.2, C15.2, C16.2, C17.2, C18.2, C19.2, C20.2, C21.-, D2.A, D4.A, D6.A, IC2.4 (V-), IC3.3 (A), J2.P$1, J3.PIN, J3.SWITCH, LED2.K (C), ON.K (C), PHOTOGATE.1, R2.1, R4.1, R17.1, R21.2, R22.2, R30.2, R33.1, REEDSWITCH.1, SG1.-, SL3.1, SL5.1, U2.3 (GND), U$1.3 (S), U$1.4 (S1), U$3.3 (S), U$3.4 (S1)
LED-B: ARDUINO_NANO1.24 (D6), R10.2
LED-G: ARDUINO_NANO1.28 (D10), R8.2
LED-R: ARDUINO_NANO1.29 (D11), R7.2
unnamed: C6.-, R2.2, R9.1
unnamed: LED1.RED, R7.1
unnamed: LED1.BLU, R8.1
unnamed: LED1.GRN, R10.1
unnamed: IC1.1 (OUT), R24.2
unnamed: IC3.2 (C), R26.1
unnamed: C15.1, IC2.5 (+IN), IC3.1 (ADJ)
unnamed: C3.+, U2.2 (CAP+)
unnamed: C3.-, U2.4 (CAP-)
unnamed: C7.1, R12.1, R13.2
unnamed: LED2.A, R11.1
unnamed: ON.A, R1.1
unnamed: R24.1, T1.3 (B)
unnamed: C8.1, IC1.3 (+IN), R13.1
unnamed: IC1.2 (-IN), R14.2, R22.1
unnamed: IC1.5 (+IN), R15.1, R17.2
unnamed: IC1.6 (-IN), R16.1, R19.A
unnamed: R14.1, R15.2, R23.1, T1.1 (E)
unnamed: R19.E, R19.S, R20.2
unnamed: IC1.7 (OUT), R18.2, R20.1
unnamed: J1.P$1, R16.2, R23.2, R25.2
unnamed: R29.1, R30.1, R31.E, R31.S
unnamed: L1.1, R31.A
OPTO: A1.TIP (LEFT), ARDUINO_NANO1.9 (A5)
PB1: ARDUINO_NANO1.30 (D12), R6.1, U$3.1, U$3.2 (P1)
PB2: ARDUINO_NANO1.25 (D7), R5.1, U$1.1, U$1.2 (P1)
PG-D4: ARDUINO_NANO1.22 (D4), PHOTOGATE.2
PWM: ARDUINO_NANO1.23 (D5), R12.2
RC-INP: ARDUINO_NANO1.1 (D13), R28.2, R29.2
RS-D12: ARDUINO_NANO1.26 (D8), REEDSWITCH.2
THERM: ARDUINO_NANO1.6 (A2), C16.1, J3.SHELL, R27.1
THERM-VCC: ARDUINO_NANO1.5 (A1), C17.1, IC2.6 (-IN), IC2.7 (OUT), R27.2
TRIG-D3: ARDUINO_NANO1.21 (D3), SL5.3

Notes on the sheet:
ARDUINO NANO
Difference Amplifier

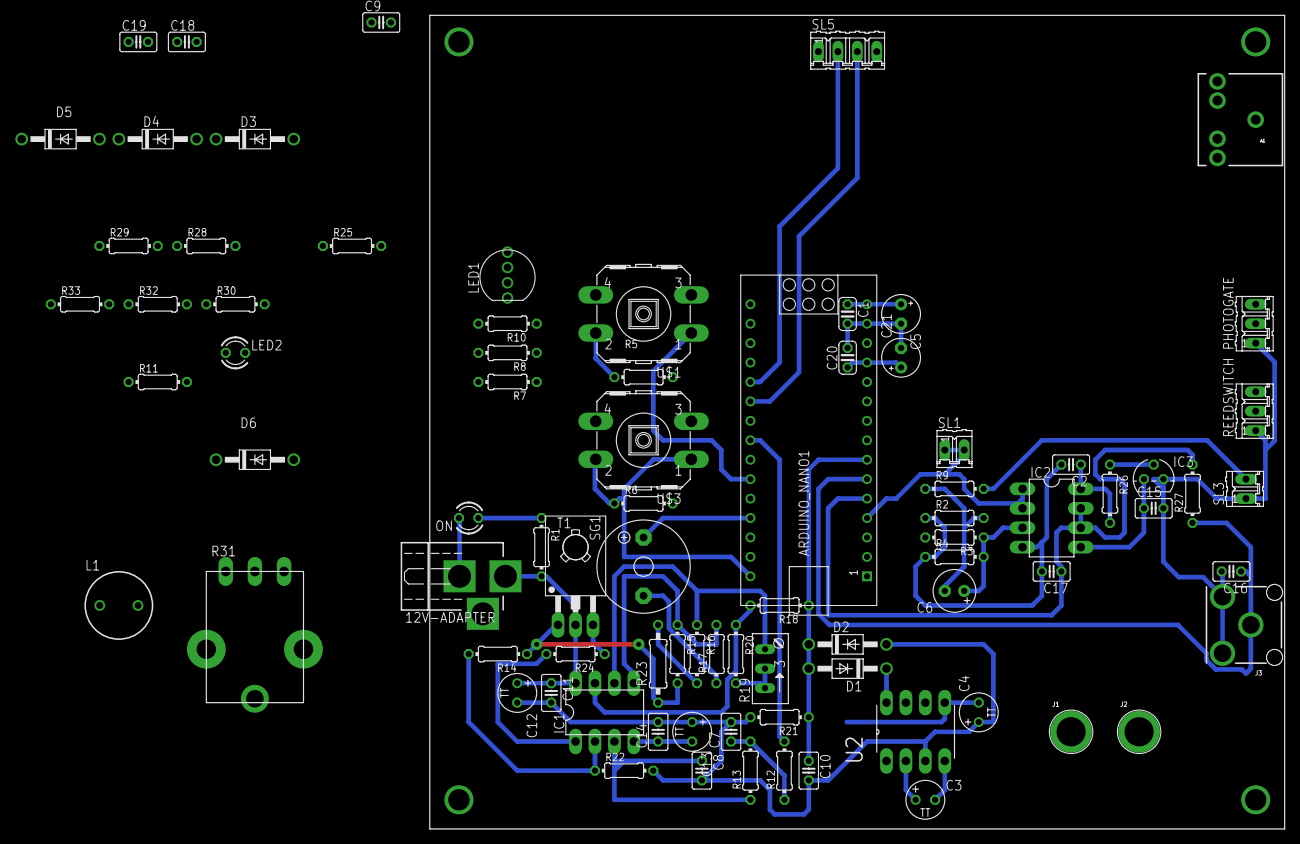
[picture p27: board ardunio-physics-board-v1.brd from above]

Board: 2 copper layers, 111.7 x 106.3 mm, 83 parts (0 on the bottom side), 49 nets.
