namanPuri/Physics-with-arduino/supplementary boards/hall/hall.brd

## EAGLE design supplementary boards/hall/hall.brd (2022-06-27)

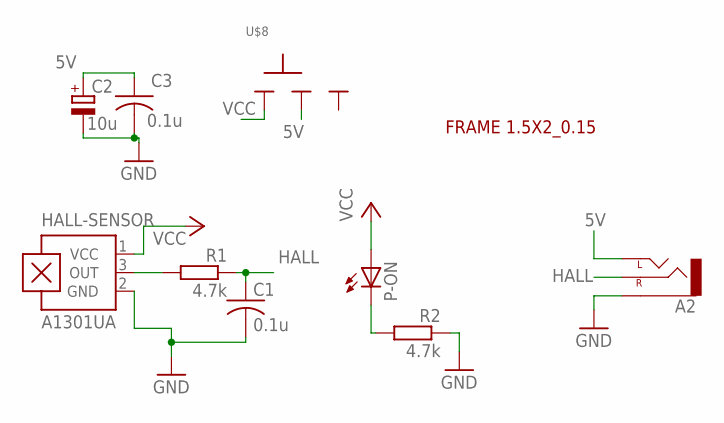
[picture p28: schematic hall.sch]

Parts:
A2: AUX-CONNECTOR_CEDT_JANUARY_2015_V5_AUDIO-JACKPTH; AUX-CONNECTOR_CEDT_JANUARY_2015_V5_AUDIO-JACK
C1, C3: 0.1u; C025-024X044
C2: 10u; E2,5-5
HALL-SENSOR: A1301UA; SIP3-UA
P-ON: LED3MM
R1, R2: 4.7k; 0204/7
U$1: FRAME_1.5X2_RAD_0.15
U$8: SLIDESWITCH-BIG; BIGSWITCH

Connections:
5V: A2.TIP (LEFT), C2.+, C3.1, U$8.2
GND: A2.SLEEVE, C1.2, C2.-, C3.2, HALL-SENSOR.2 (GND), R2.1
HALL: A2.RING (RIGHT), C1.1, R1.1
unnamed: HALL-SENSOR.3 (OUT), R1.2
unnamed: P-ON.K (C), R2.2
VCC: HALL-SENSOR.1 (VCC), P-ON.A, U$8.1

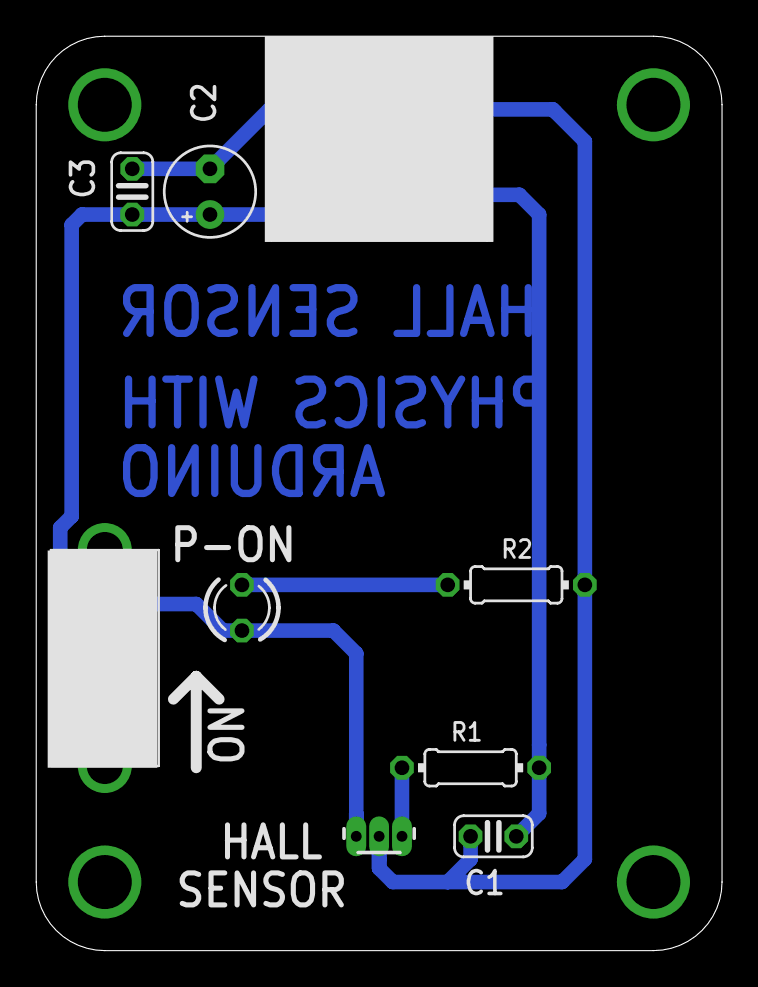
[picture p29: board hall.brd from above]

Board: 2 copper layers, 38.1 x 50.8 mm, 10 parts (0 on the bottom side), 6 nets.
